zae-bayern/EGO-PHASM/README.md

Open-Source Repository für das BMWE-finanzierte Mikroprojekt "EGO-PHASM" des ZAE Bayerns.
