zae-bayern/EGO-PHASM/Data/Phasordata_Sample/README

This directory contains samples of the collected synchrophasor data in .csv format.
