zae-bayern/EGO-PHASM/Data/Netzfrequenz_2Hz_Nuernberg/README

Data collected with OpenPMU device in Nürnberg, Germany.
Frequency averaged every 25 periods for a report rate of 2Hz.
