zae-bayern/EGO-PHASM/PCBs/OpenPMU BBB CAPE ZAE/plots/OpenPMU BBB CAPE ZAE__Assembly.pdf

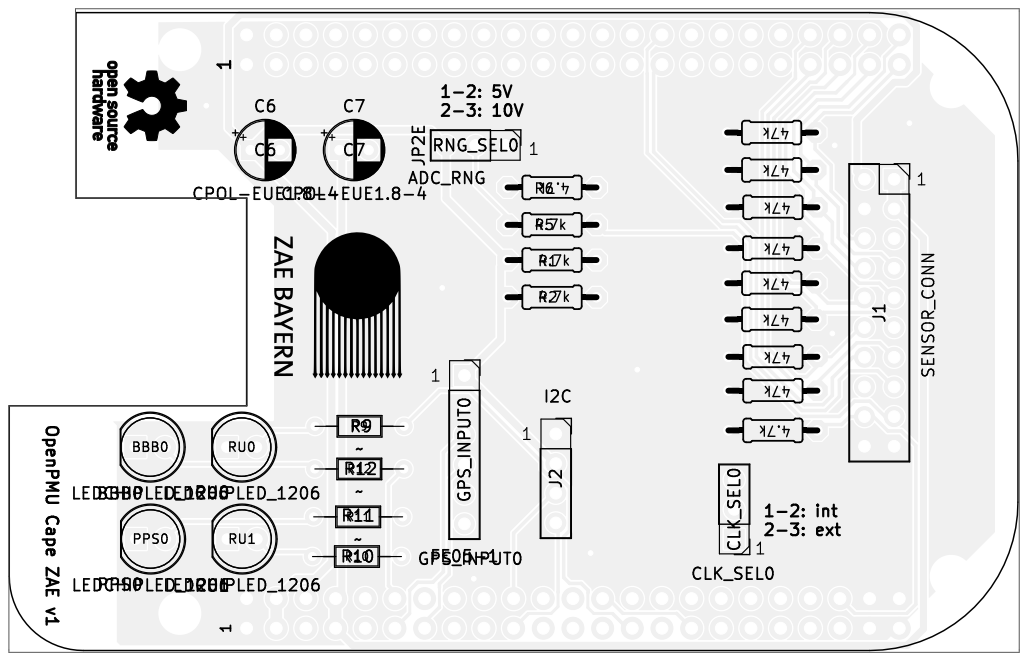
[picture p1: page 1]

Id: 1/1 Title: OpenPMU BBB Shield ZAE

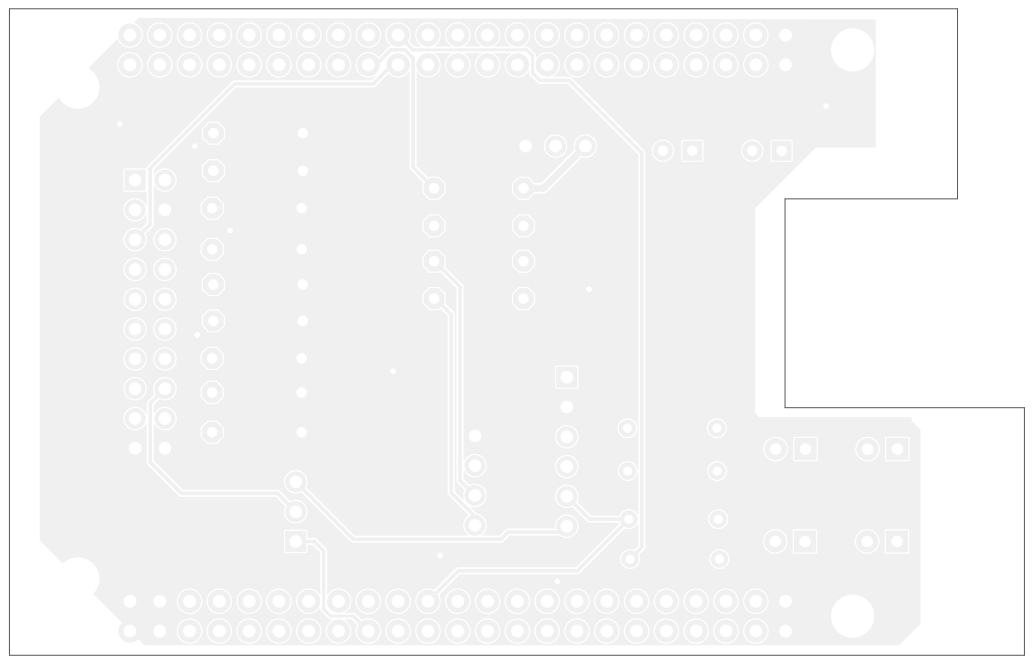
[picture p2: page 2]
D Date: 2026-02-18 KiCad; E.D.A. 8.0.9 Size: A4; Rev: 1.1; File: OpenPMU; BBB CAPE ZAE.kicad_pcb Sheet: Black; And; White; BOT; ZAE; Bayern e. V. T. Grassmann Board2Pdf:; Black; BOT -; Page 2/2

Id: 1/1 Title: OpenPMU BBB Shield ZAE
