zae-bayern/EGO-PHASM/PCBs/OpenPMU Sensor Board Rev3/plots/OpenPMU Sensor Board Rev3__Assembly.pdf

1 | 2 | 3 | 4 | 5 | 6

A

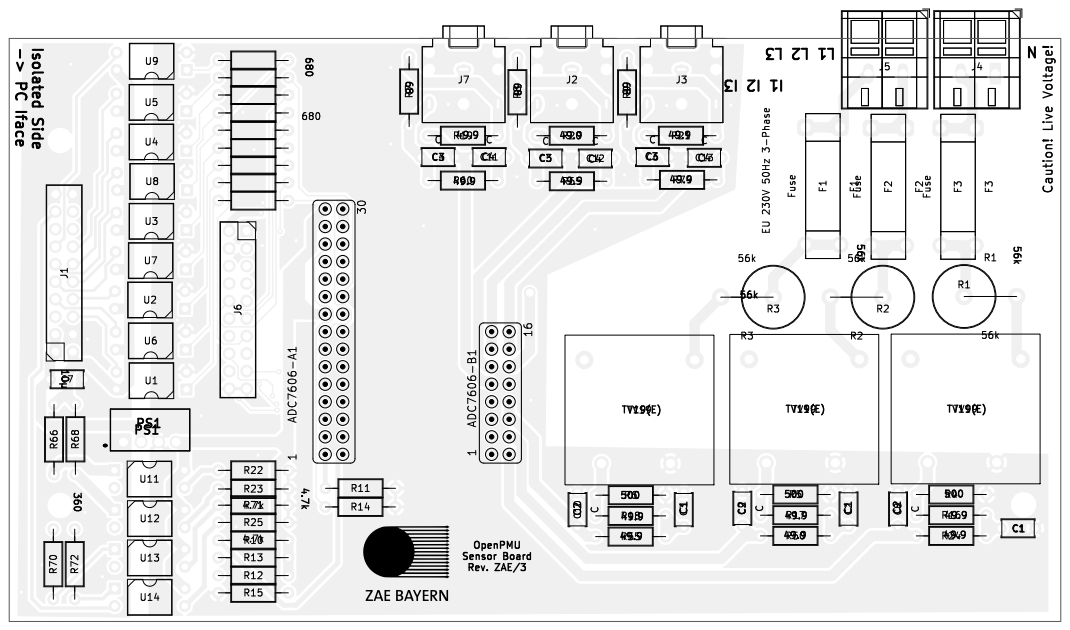
[picture p3: page 1]

500 ⁶⁸ Isolated Side ⁻> PC Iface

Id: 1/1 Title: OpenPMU Sensor Board

1 | 2 | 3 | 4 | 5 | 6

A

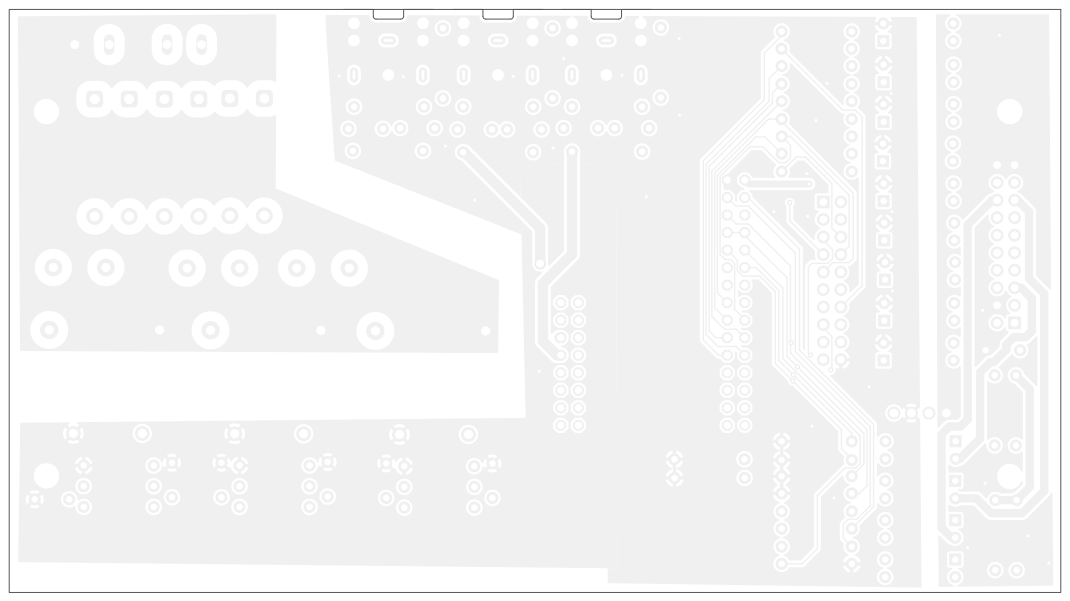
[picture p4: page 2]
D Date: 2026-02-18 KiCad; E.D.A. 8.0.9 Size: A4; Rev: 2; File: OpenPMU Sensor; Board; Rev3.kicad_pcb Sheet: Black; And; White; BOT; ZAE; Bayern e. V. Board2Pdf:; Black; BOT -; Page 2/2

Id: 1/1 Title: OpenPMU Sensor Board
