zae-bayern/EGO-PHASM/PCBs/OpenPMU BBB CAPE ZAE/OpenPMU BBB CAPE ZAE.kicad_pcb

## KiCad design PCBs/OpenPMU BBB CAPE ZAE/OpenPMU BBB CAPE ZAE.kicad_pcb (2026-09-16)

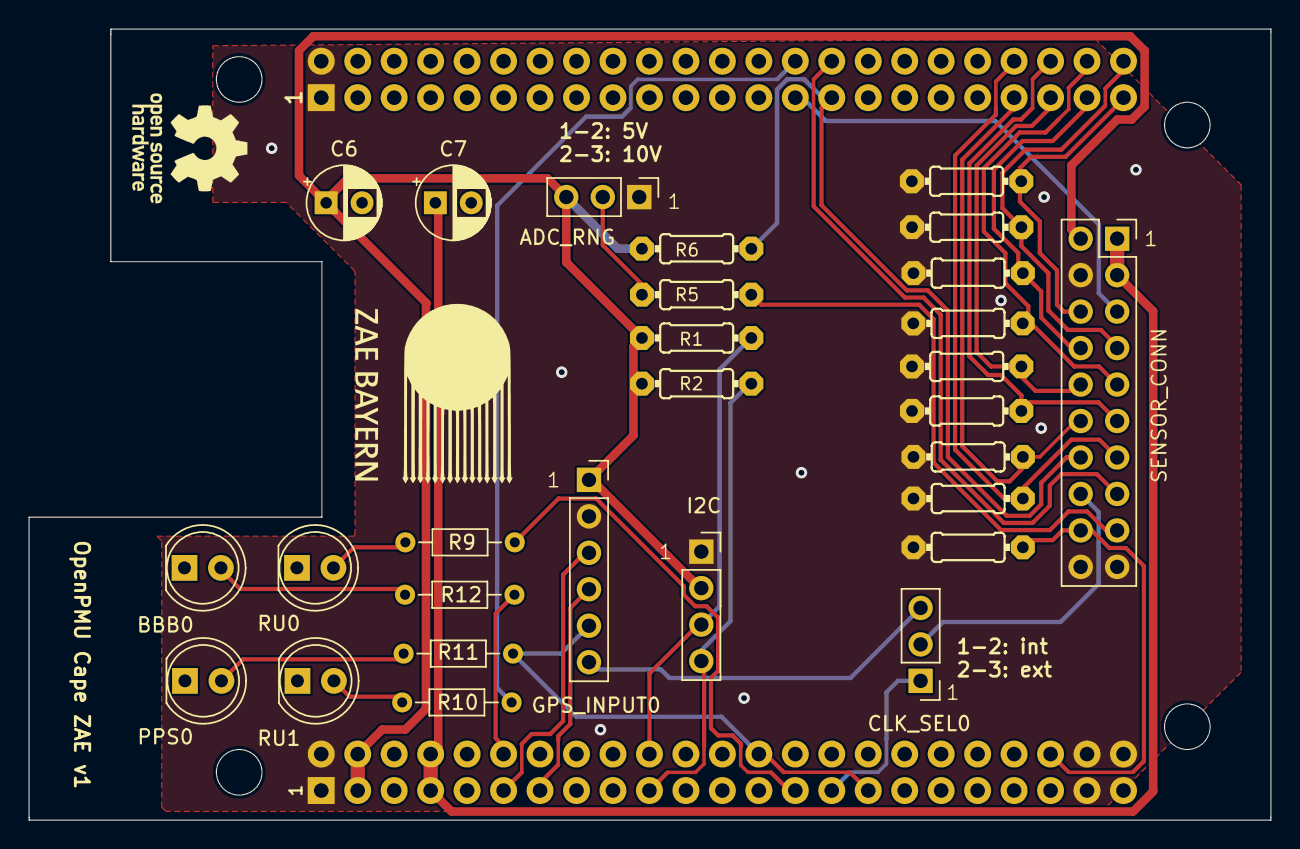
[picture p7: board OpenPMU BBB CAPE ZAE.kicad_pcb from above]

Board: 2 copper layers, 86.5 x 55.1 mm, 29 parts (0 on the bottom side), 27 nets.

Parts:
BBB0: LEDCHIPLED_1206; LED_D5.0mm
C6, C7: CPOL-EUE1.8-4; CP_Radial_D5.0mm_P2.50mm
CLK_SEL0: JP2E; PinHeader_1x03_P2.54mm_Vertical
GPS_INPUT0: FE05-1; PinSocket_1x06_P2.54mm_Vertical
J1: Conn_01x20; PinSocket_2x10_P2.54mm_Vertical
J2: PINHD_1x4_Female; PinSocket_1x04_P2.54mm_Vertical
PPS0: LEDCHIPLED_1206; LED_D5.0mm
R1, R2, R5, R6, R7: 4.7k; 0204_7
R4, R8, R13, R14, R15, R16, R17, R18: 47k; 0204_7
R9, R10, R11, R12: R_Axial_DIN0204_L3.6mm_D1.6mm_P7.62mm_Horizontal
RNG_SEL0: JP2E; PinHeader_1x03_P2.54mm_Vertical
RU0, RU1: LEDCHIPLED_1206; LED_D5.0mm
U$1: BEAGLE_BONE_BLACK_CAPE; BEAGLE_BONE_BLACK_CAPE_509

Connections:
3.3V: GPS_INPUT0.1, J1.2, J2.2, R1.2, R2.2, R6.2, RNG_SEL0.3, U$1.P9.3, U$1.P9.4
5V: J1.1, J1.3, U$1.P9.7, U$1.P9.8
/BUSY: J1.14, R6.1, U$1.P8.29
/CONVST: CLK_SEL0.2, J1.16
/CONVST_OUT: CLK_SEL0.1, U$1.P9.29
/CS: J1.5, U$1.P8.27
/DB0: J1.6, R4.1, U$1.P8.45
/DB1: J1.7, R8.1, U$1.P8.46
/DB2: J1.8, R13.1, U$1.P8.43
/DB3: J1.9, R14.1, U$1.P8.44
/DB4: J1.10, R15.1, U$1.P8.41
/DB5: J1.11, R16.1, U$1.P8.42
/DB6: J1.12, R17.1, U$1.P8.39
/DB7: J1.13, R18.1, U$1.P8.40
/FRST: J1.18, R7.1, U$1.P9.42
/GPS_1PPS: GPS_INPUT0.5, R11.2, U$1.P9.26, U$1.P9.31
/GPS_RX: GPS_INPUT0.4, U$1.P9.13
/GPS_TX: GPS_INPUT0.3, U$1.P9.11
/LED_BBB: R12.2, U$1.P9.12
/LED_PRU0: R9.2, U$1.P9.27
/LED_PRU1: R10.2, U$1.P8.28
/RAGE: J1.17, R5.1
/RD: J1.15, U$1.P8.30
/RNG_SEL: R5.2, RNG_SEL0.2
/SCL: J2.4, R2.1, U$1.P9.19
/SDA: J2.3, R1.1, U$1.P9.20
GND: GPS_INPUT0.2, J1.4, J1.19, J1.20, J2.1, R4.2, R7.2, R8.2, R13.2, R14.2, R15.2, R16.2, R17.2, R18.2, RNG_SEL0.1, U$1.P8.1, U$1.P8.2, U$1.P9.1, U$1.P9.2, U$1.P9.43, U$1.P9.44, U$1.P9.45, U$1.P9.46
