zae-bayern/EGO-PHASM/PCBs/OpenPMU Sensor Board Rev3/OpenPMU Sensor Board Rev3.kicad_pcb

## KiCad design PCBs/OpenPMU Sensor Board Rev3/OpenPMU Sensor Board Rev3.kicad_pcb (2026-09-16)

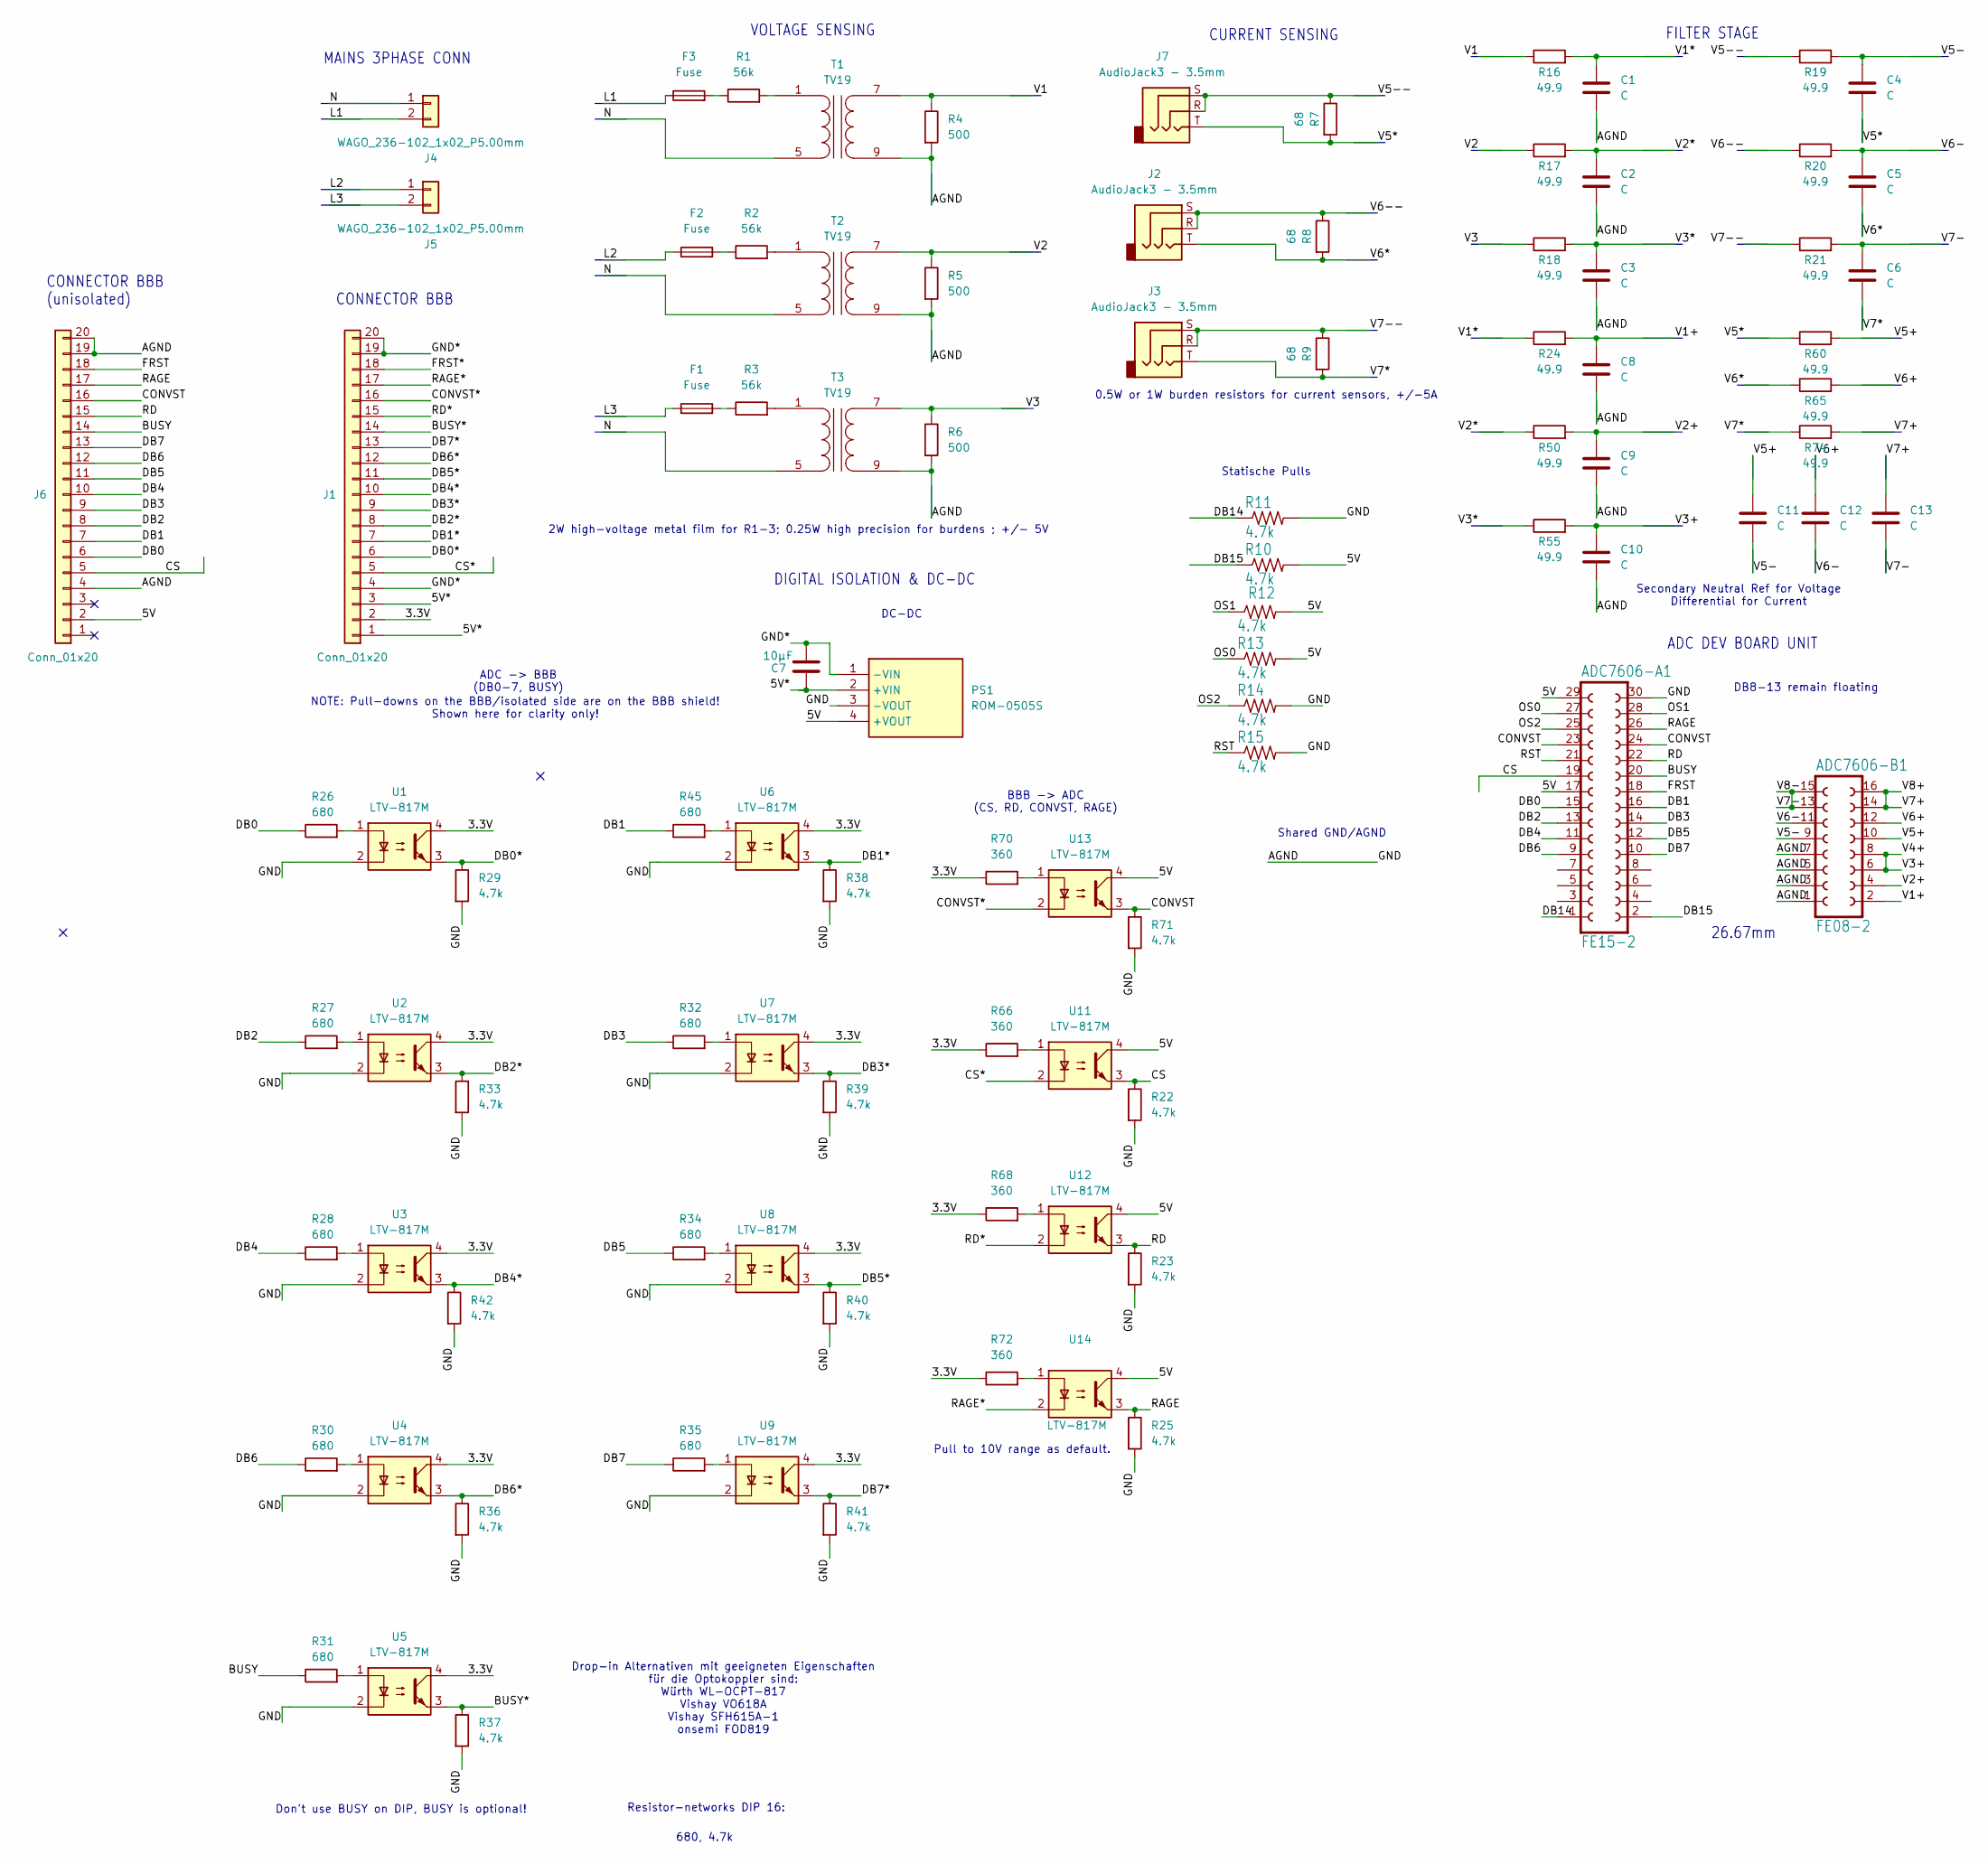
[picture p8: schematic OpenPMU Sensor Board Rev3.kicad_sch, OpenPMU Sensor Board]

Parts:
ADC7606-A1: FE15-2
ADC7606-B1: FE08-2
C1, C2, C3, C4, C5, C6, C8, C9, C10, C11, C12, C13: C; C_Disc_D4.7mm_W2.5mm_P5.00mm
C7: 10µF; C_Disc_D4.7mm_W2.5mm_P5.00mm
F1, F2, F3: Fuse; Fuseholder_Clip-5x20mm_Schurter_CQM_Inline_P20.60x5.00mm_D1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
J1, J6: Conn_01x20; PinSocket_2x10_P2.54mm_Vertical
J2, J3, J7: AudioJack3 - 3.5mm; Jack_3.5mm_CUI_SJ1-3523N_Horizontal
J4, J5: WAGO_236-102_1x02_P5.00mm; TerminalBlock_WAGO_236-102_1x02_P5.00mm_45Degree
PS1: ROM-0505S; Mouser Part Number 919-ROM-0505S
R1, R2, R3: 56k; R_Axial_DIN0411_L9.9mm_D3.6mm_P15.24mm_Horizontal
R4, R5, R6: 500; R_Axial_DIN0207_L6.3mm_D2.5mm_P10.16mm_Horizontal
R7, R8, R9: 68; R_Axial_DIN0207_L6.3mm_D2.5mm_P10.16mm_Horizontal
R10, R11, R12, R13, R14, R15, R22, R23, R25, R29, R33, R36, R37, R38, R39, R40, R41, R42, R71: 4.7k; R_Axial_DIN0207_L6.3mm_D2.5mm_P10.16mm_Horizontal
R16, R17, R18, R19, R20, R21, R24, R50, R55, R60, R65, R74: 49.9; R_Axial_DIN0207_L6.3mm_D2.5mm_P10.16mm_Horizontal
R26, R27, R28, R30, R31, R32, R34, R35, R45: 680; R_Axial_DIN0207_L6.3mm_D2.5mm_P10.16mm_Horizontal
R66, R68, R70, R72: 360; R_Axial_DIN0207_L6.3mm_D2.5mm_P10.16mm_Horizontal
T1, T2, T3: TV19; Transformer_TV19
U1, U2, U3, U4, U5, U6, U7, U8, U9, U11, U12, U13, U14: LTV-817M; DIP-4_W10.16mm

Connections:
/3.3V: J1.2, R66.1, R68.1, R70.1, R72.1, U1.4, U2.4, U3.4, U4.4, U5.4, U6.4, U7.4, U8.4, U9.4
/5V: ADC7606-A1.17, ADC7606-A1.29, J6.2, PS1.4 (+VOUT), R10.2, R12.2, R13.2, U11.4, U12.4, U13.4, U14.4
/5V*: C7.2, J1.1, J1.3, PS1.2 (+VIN)
/BUSY: ADC7606-A1.20, J6.14, R31.1
/BUSY*: J1.14, R37.1, U5.3
/CONVST: ADC7606-A1.23, ADC7606-A1.24, J6.16, R71.1, U13.3
/CONVST*: J1.16, U13.2
/CS: ADC7606-A1.19, J6.5, R22.1, U11.3
/CS*: J1.5, U11.2
/DB0: ADC7606-A1.15, J6.6, R26.1
/DB0*: J1.6, R29.1, U1.3
/DB1: ADC7606-A1.16, J6.7, R45.1
/DB1*: J1.7, R38.1, U6.3
/DB2: ADC7606-A1.13, J6.8, R27.1
/DB2*: J1.8, R33.1, U2.3
/DB3: ADC7606-A1.14, J6.9, R32.1
/DB3*: J1.9, R39.1, U7.3
/DB4: ADC7606-A1.11, J6.10, R28.1
/DB4*: J1.10, R42.1, U3.3
/DB5: ADC7606-A1.12, J6.11, R34.1
/DB5*: J1.11, R40.1, U8.3
/DB6: ADC7606-A1.9, J6.12, R30.1
/DB6*: J1.12, R36.1, U4.3
/DB7: ADC7606-A1.10, J6.13, R35.1
/DB7*: J1.13, R41.1, U9.3
/DB14: ADC7606-A1.1, R11.1
/DB15: ADC7606-A1.2, R10.1
/FRST*: J1.18
/GND*: C7.1, J1.4, J1.19, J1.20, PS1.1 (-VIN)
/L1: F3.1, J4.2
/L2: F2.1, J5.1
/L3: F1.1, J5.2
/N: J4.1, T1.5 (AB), T2.5 (AB), T3.5 (AB)
/OS0: ADC7606-A1.27, R13.1
/OS1: ADC7606-A1.28, R12.1
/OS2: ADC7606-A1.25, R14.1
/RAGE: ADC7606-A1.26, J6.17, R25.1, U14.3
/RAGE*: J1.17, U14.2
/RD: ADC7606-A1.22, J6.15, R23.1, U12.3
/RD*: J1.15, U12.2
/RST: ADC7606-A1.21, R15.1
/V1: R4.1, R16.1, T1.7 (SB)
/V1*: C1.1, R16.2, R24.1
/V1+: ADC7606-B1.2, C8.1, R24.2
/V2: R5.1, R17.1, T2.7 (SB)
/V2*: C2.1, R17.2, R50.1
/V2+: ADC7606-B1.4, C9.1, R50.2
/V3: R6.1, R18.1, T3.7 (SB)
/V3*: C3.1, R18.2, R55.1
/V3+: ADC7606-B1.6, ADC7606-B1.8, C10.1, R55.2
/V5*: C4.2, J7.T, R7.2, R60.1
/V5+: ADC7606-B1.10, C11.1, R60.2
/V5-: ADC7606-B1.9, C4.1, C11.2, R19.2
/V5--: J7.R, J7.S, R7.1, R19.1
/V6*: C5.2, J2.T, R8.2, R65.1
/V6+: ADC7606-B1.12, C12.1, R65.2
/V6-: ADC7606-B1.11, C5.1, C12.2, R20.2
/V6--: J2.R, J2.S, R8.1, R20.1
/V7*: C6.2, J3.T, R9.2, R74.1
/V7+: ADC7606-B1.14, ADC7606-B1.16, C13.1, R74.2
/V7-: ADC7606-B1.13, ADC7606-B1.15, C6.1, C13.2, R21.2
/V7--: J3.R, J3.S, R9.1, R21.1
unnamed: F1.2, R3.1
unnamed: F2.2, R2.1
unnamed: F3.2, R1.1
unnamed: R26.2, U1.1
unnamed: R27.2, U2.1
unnamed: R28.2, U3.1
unnamed: R30.2, U4.1
unnamed: R31.2, U5.1
unnamed: R32.2, U7.1
unnamed: R34.2, U8.1
unnamed: R35.2, U9.1
unnamed: R45.2, U6.1
unnamed: R66.2, U11.1
unnamed: R68.2, U12.1
unnamed: R70.2, U13.1
unnamed: R72.2, U14.1
unnamed: R1.2, T1.1 (AA)
unnamed: R2.2, T2.1 (AA)
unnamed: R3.2, T3.1 (AA)

Notes on the sheet:
MAINS 3PHASE CONN
NOTE: Pull-downs on the BBB/isolated side are on the BBB shield! Shown here for clarity only!
Don't use BUSY on DIP, BUSY is optional!
Pull to 10V range as default.
680, 4.7k
CONNECTOR BBB (unisolated)
FILTER STAGE
VOLTAGE SENSING
0.5W or 1W burden resistors for current sensors, +/-5A
ADC DEV BOARD UNIT
DC-DC
Resistor-networks DIP 16:
Shared GND/AGND
CURRENT SENSING
Statische Pulls
26.67mm
ADC -> BBB (DB0-7, BUSY)
DIGITAL ISOLATION & DC-DC
BBB -> ADC (CS, RD, CONVST, RAGE)
Drop-in Alternativen mit geeigneten Eigenschaften für die Optokoppler sind: Würth WL-OCPT-817 Vishay VO618A Vishay SFH615A-1 onsemi FOD819
2W high-voltage metal film for R1-3; 0.25W high precision for burdens ; +/- 5V
Secondary Neutral Ref for Voltage Differential for Current
DB8-13 remain floating
CONNECTOR BBB

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
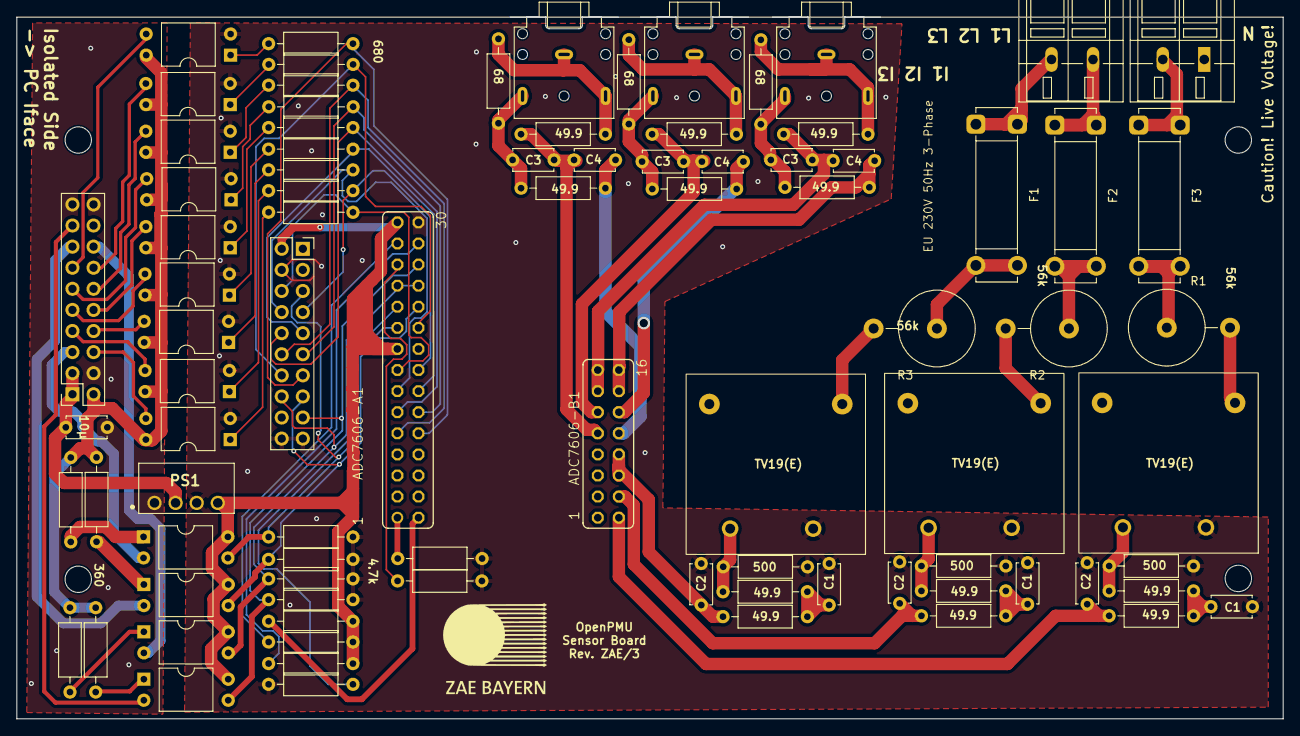
[picture p9: board OpenPMU Sensor Board Rev3.kicad_pcb from above]

Board: 2 copper layers, 152.5 x 84.5 mm, 86 parts (0 on the bottom side), 82 nets.
