zae-bayern/EGO-PHASM/(commit log)

2026-09-16 Add GNU GPL v3 license
    Added the GNU General Public License version 3 to the PCBs folder of the project.
2026-09-16 Add README file for PCBs directory
2026-09-16 Update README with PCB modifications overview
    Added an overview of modifications to the PCBs.
2026-09-16 Added Sensor Board KiCad folder.
    [IL711-2E.step, OpenPMU Sensor Board Rev3.kicad_pcb, OpenPMU Sensor Board Rev3.kicad_sch]
2026-09-16 Added OpenPMU BBB Cape ZAE KiCad folder.
    [OpenPMU BBB CAPE ZAE.kicad_pcb, OpenPMU BBB CAPE ZAE.kicad_sch]
2026-09-16 Add README for 2Hz frequency data collection in Nuremberg
2026-09-16 Add Creative Commons Attribution 4.0 License to Data/
    This file contains the Creative Commons Attribution 4.0 International Public License, outlining the terms and conditions for using the licensed material.
2026-09-21 Add README for synchrophasor data samples
